Jubayed-Sahel/Neural-Rover-RC-Car/Project Files/Diagrams.docx

Main Diagram

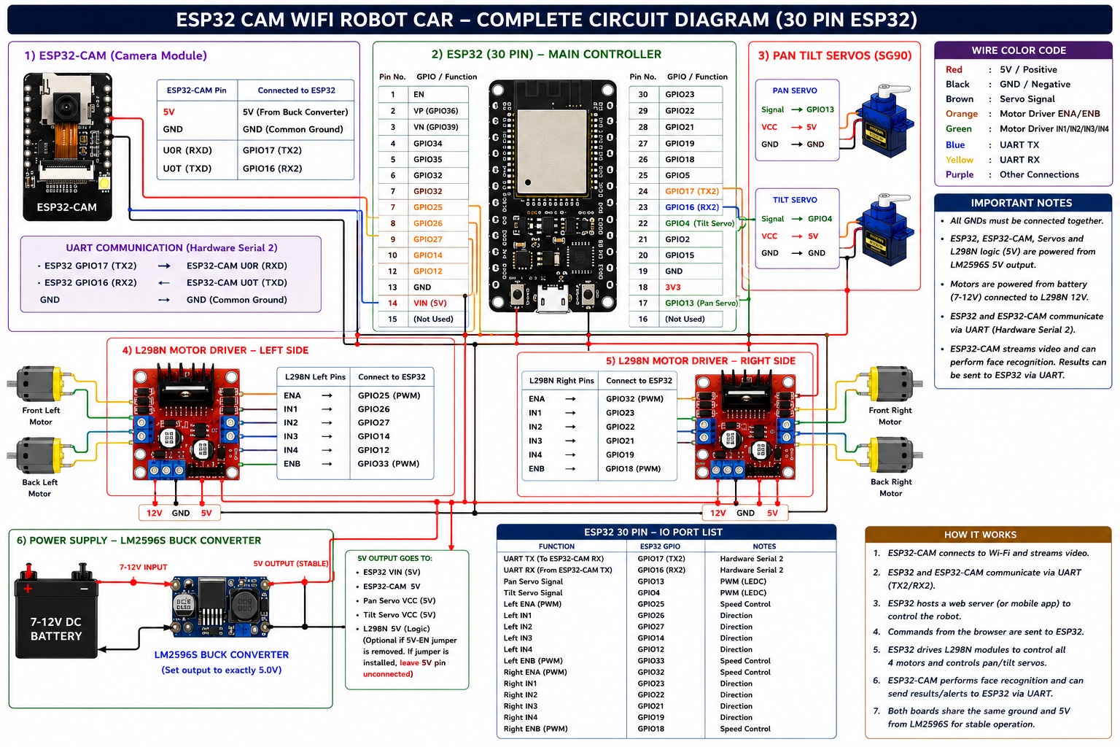
[picture p5: figure]

ESP32-CAM-Connection with hardware


ESP32-CAM Code Upload Diagram

- Must connect arduino reset pin with arduino gnd

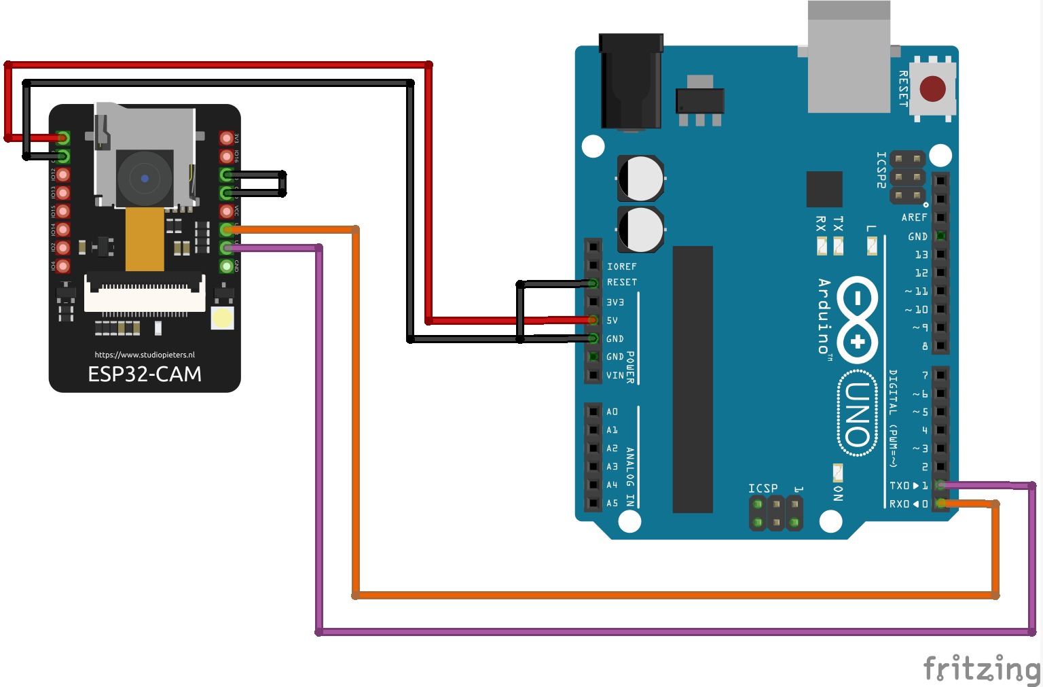
[picture p6: figure]
