Jubayed-Sahel/Neural-Rover-RC-Car/Project Files/Arduino IDE Settings_.docx

1. ESP 32 CAM Settings:

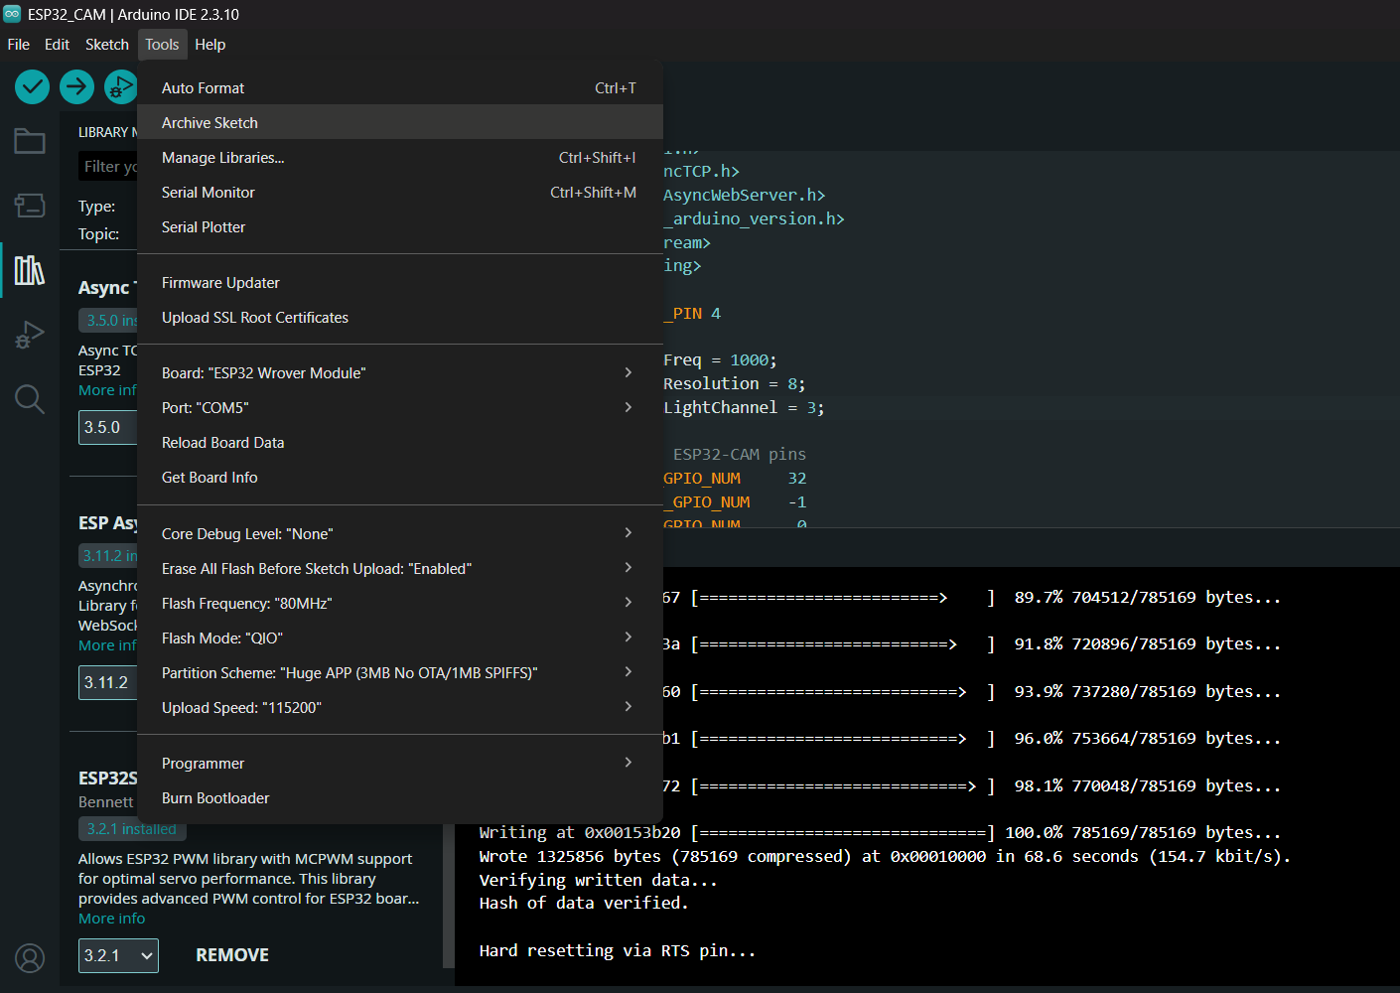
[picture p7: figure]

2. ESP 32 Contoller:
3. LIbraries :

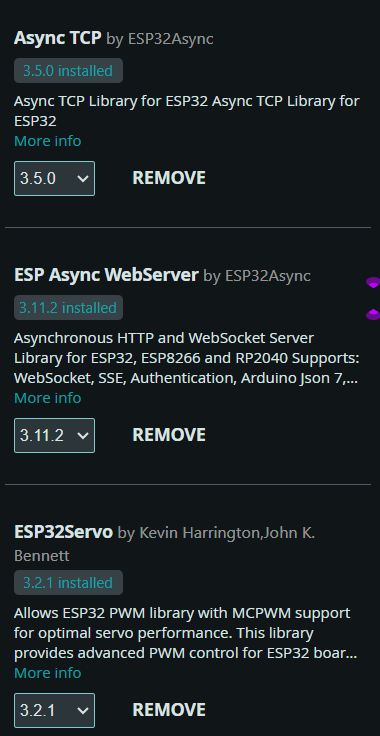
[picture p8: figure]
