Jubayed-Sahel/Neural-Rover-RC-Car/Project Files/CSE499B_Fall_Detection_Architecture.png

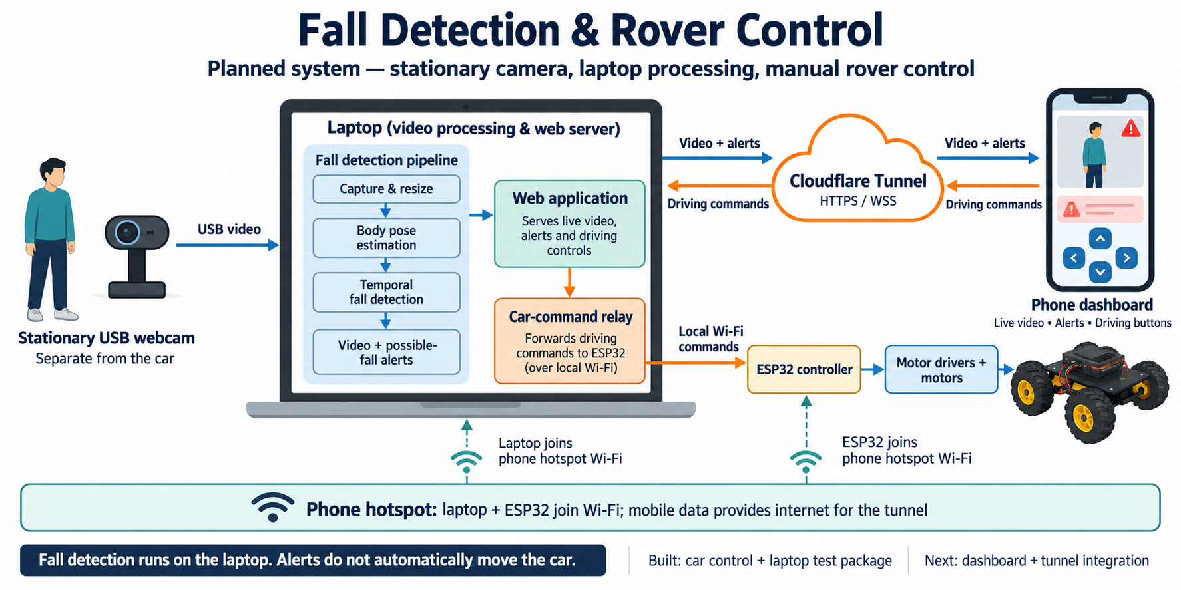
Project Files/CSE499B_Fall_Detection_Architecture.png
