Jubayed-Sahel/Neural-Rover-RC-Car/Project Files/Neural Rover Architecture Detailed.png

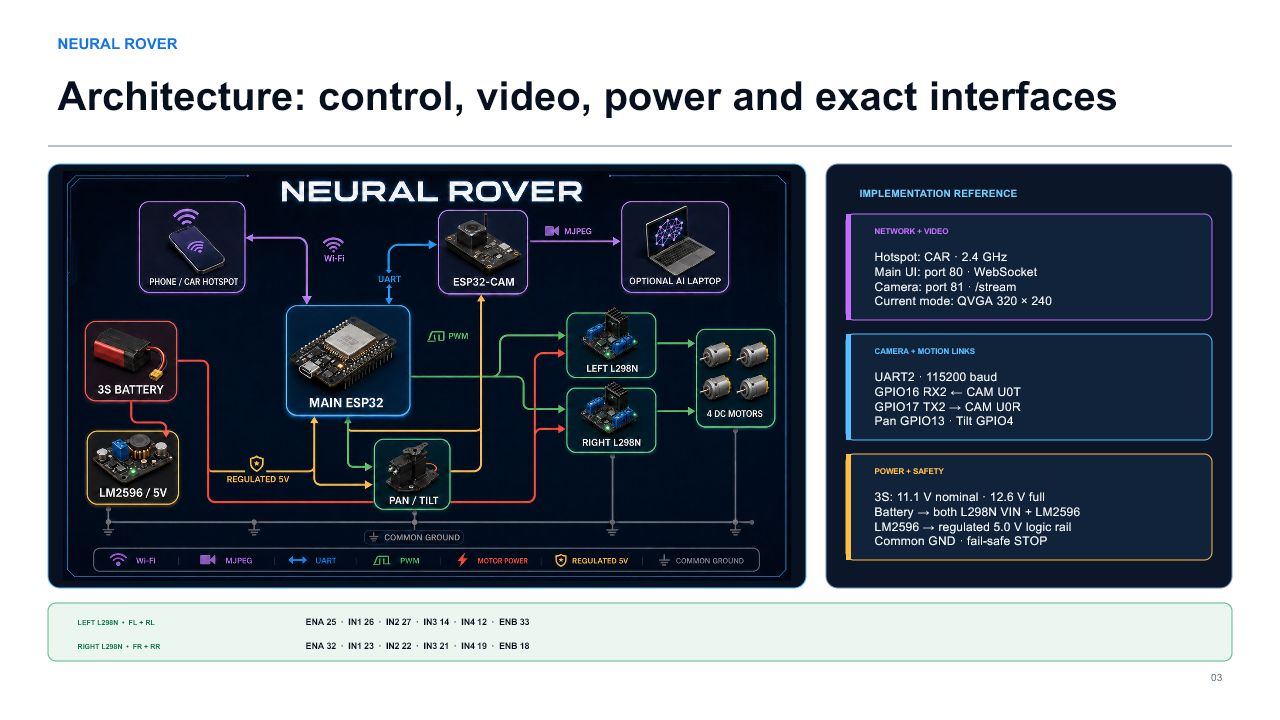
Project Files/Neural Rover Architecture Detailed.png
