Jubayed-Sahel/Neural-Rover-RC-Car/Project Files/Neural Rover Full Project Diagram.png

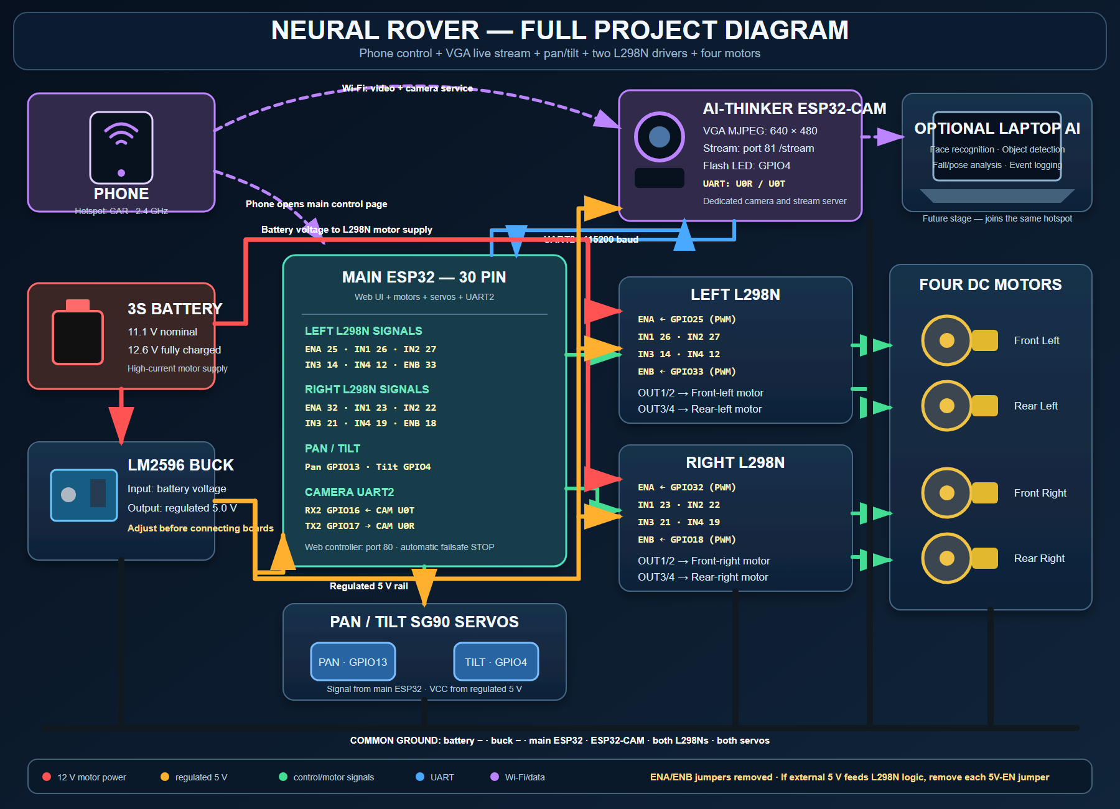
Project Files/Neural Rover Full Project Diagram.png
