Jubayed-Sahel/Neural-Rover-RC-Car/Project Files/Neural Rover Mobile Control Page.png

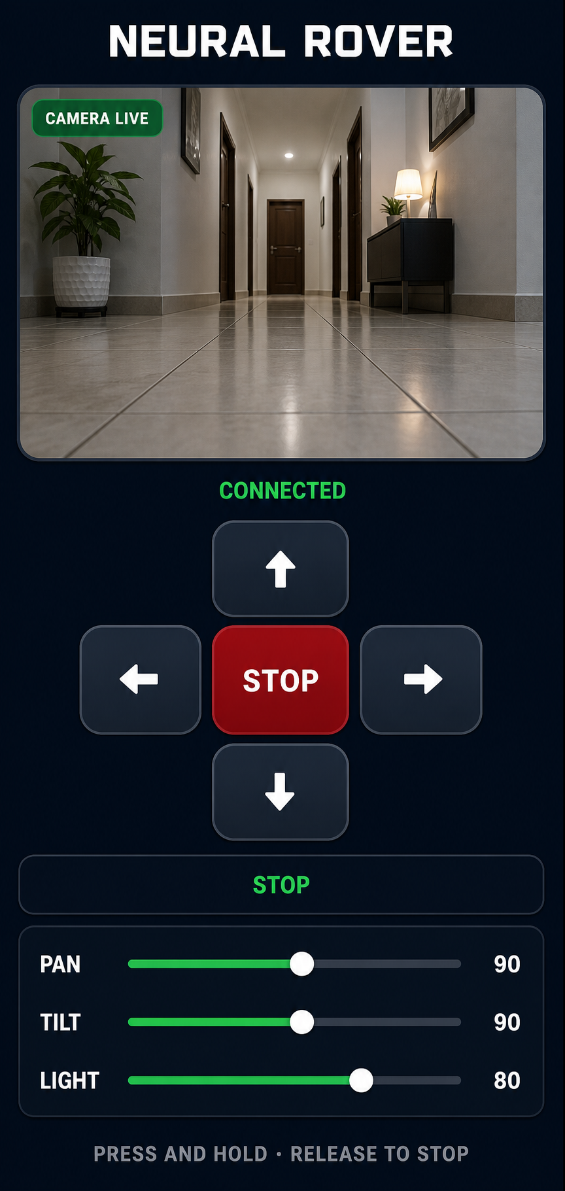
Project Files/Neural Rover Mobile Control Page.png
