Jubayed-Sahel/Neural-Rover-RC-Car/install in laptop/known_faces/README.txt

Reference photographs are stored here.

The capture program automatically creates one subfolder per person:

known_faces/
  Person_Name/
    image_01.jpg
    image_02.jpg

Use 5-10 clear images per person with slightly different face angles.
