Jubayed-Sahel/Neural-Rover-RC-Car/CSE499B_Smart_Hazard_Inspection_Rover_Proposal.docx

CSE499B PROJECT PROPOSAL

# ThermoGuard Rover

A Low-Cost Smart Hazard Inspection Rover

Remote inspection, thermal and environmental sensing, assisted driving, and fail-safe operation

Course | CSE499B - Senior Design Project
Project | Neural Rover / ThermoGuard Rover
Team | Four-member project group
Prepared for | Project supervisor and evaluation committee

Project direction: The ESP32-CAM remains a live situational-awareness camera. The main CSE499B contribution is reliable sensor-based hazard detection and safer remote operation, not face recognition or QR-code navigation.

Status entering CSE499B

The core 499A rover platform is operational; face recognition is intentionally removed from the next-phase scope.

# 1. Executive Summary

ThermoGuard Rover is a low-cost mobile platform for remotely inspecting rooms and equipment when immediate human entry may be inconvenient or unsafe. The operator drives the rover through a mobile-friendly dashboard while the ESP32-CAM provides live visual feedback. Contactless temperature sensing, ambient environmental sensing, obstacle ranging, battery monitoring, and communication supervision operate continuously. When the system detects an abnormal condition, it warns the operator, records the event, captures visual evidence, and can place the rover in a safe-stop state.

The proposal deliberately avoids face recognition and QR-code navigation. The existing camera is retained for live observation and event snapshots, where its image quality is adequate. Safety-critical decisions rely primarily on dedicated sensors, which creates a more dependable and testable CSE499B contribution.

Core research question: Can an affordable sensor-assisted rover identify thermal and environmental warning conditions while improving the safety and reliability of remote inspection compared with video-only manual control?

# 2. Background and 499A Baseline

The CSE499A phase established the physical rover and remote-control foundation. The platform already combines a four-wheel chassis, motor drivers, an ESP32-based control unit, an ESP32-CAM, pan-and-tilt camera movement, Wi-Fi communication through a mobile hotspot, and a browser-based control interface. Motor-control safeguards such as command timeout and direction-reversal dead time are also part of the baseline.

Existing capability | Status entering CSE499B
Four-wheel movement and motor control | Operational
Mobile hotspot connectivity | Operational
Browser/mobile driving interface | Operational
ESP32-CAM live stream | Operational for situational awareness
Pan-and-tilt camera control | Operational
Communication-loss motor timeout | Implemented baseline safeguard
Face recognition | Not continued because camera quality and operating conditions make it unreliable

# 3. Problem Statement and Real-Life Relevance

Electrical rooms, server rooms, laboratories, storage areas, kitchens, and recently affected spaces may contain overheating equipment, poor air conditions, obstacles, smoke, or uncertain visibility. A person often has to approach the area merely to understand the situation. A small remotely operated rover can provide an initial view and collect measurements while allowing the operator to remain at a safer distance.

The system is not intended to replace certified fire, gas, or industrial safety equipment. Its role is early warning and remote situational awareness: helping the operator decide whether closer human inspection is appropriate and preserving a record of what the rover observed.

# 4. Proposed CSE499B Objectives

- Integrate contactless thermal sensing to identify unusual heat sources or equipment hotspots.
- Measure ambient temperature, humidity, and air-quality trends using an environmental sensor.
- Add obstacle-distance sensing and prevent unsafe forward movement near an obstruction.
- Monitor battery voltage/current and warn the operator before unsafe shutdown.
- Extend the phone dashboard with live sensor values, clear warnings, rover state, and event history.
- Implement a state-based safety controller for manual driving, warning, and automatic safe stop.
- Evaluate the rover quantitatively using repeatable inspection and communication tests.

# 5. Intended Use Cases

Use case | Rover contribution | Operator benefit
Electrical equipment inspection | Measures surface temperature and shows the equipment through live video | Reduces unnecessary close approach to a suspected hotspot
Room reconnaissance | Streams video and reports environment and obstacles | Provides initial awareness before entering
Laboratory or storage check | Detects unusual heat and air-quality change and records an alert | Supports faster, evidence-based decisions
Dark or narrow-space inspection | Uses camera lighting, pan/tilt, and proximity sensing | Reaches viewpoints that are difficult to inspect directly

# 6. System Architecture

The system is divided into rover-side sensing and control, Wi-Fi communication, and an operator dashboard. The mobile hotspot remains the network access point. Heavy image analysis is not required for the minimum system, so the ESP32-CAM can focus on streaming while the main ESP32 handles motion and sensor messages.

Data flow: Sensors and ESP32-CAM -> ESP32/Wi-Fi network -> mobile-friendly dashboard -> operator commands -> safety validation -> motor and pan/tilt actuation.

## 6.1 Rover-side modules

Module | Purpose | Recommended choice
Visible camera | Live view, pan/tilt observation, and alert snapshots | Existing ESP32-CAM
Thermal sensing | Contactless hotspot measurement | MLX90614 for a simple point reading; MLX90640 for an optional 32 x 24 heat map
Environmental sensing | Temperature, humidity, and air-quality trend | BME680 or BME688
Obstacle sensing | Front clearance and collision prevention | VL53L0X/VL53L1X ToF sensor; optional left/right sensors
Power sensing | Battery voltage and current | INA219 or INA226
Rover orientation | Tip-over warning | Optional MPU6050 IMU
Local warning | Immediate visible/audible alert | Buzzer and status LED

## 6.2 Camera role

The ESP32-CAM is not used for face recognition. It provides a low-bandwidth first-person view, allows the operator to aim the camera using pan/tilt, captures an image when a sensor alarm occurs, and visually confirms whether a detected hotspot or obstacle corresponds to a real object. This role remains valuable even at moderate resolution.

## 6.3 Safety-state logic

State | Meaning | Typical transition
MANUAL | Normal remote driving | Operator enables assisted mode
ASSISTED | Manual driving with obstacle and safety checks | Obstacle, low battery, weak connection, or hazard warning
WARNING | A condition needs operator attention | Condition clears or becomes critical
SAFE STOP | Motors are disabled and movement commands are rejected | Operator acknowledges and conditions become safe

# 7. Functional Requirements

- The dashboard shall display live video, drive controls, camera controls, sensor readings, battery status, connection status, and the current safety state.
- The rover shall stop or reject forward movement when the front distance is below a configurable limit.
- The rover shall generate a thermal warning when a measured value exceeds a configurable threshold or differs significantly from the local baseline.
- The rover shall issue an air-quality trend warning without claiming certified gas identification.
- The rover shall stop its motors when valid control commands are not received within the configured timeout.
- The system shall record timestamped movement, warning, connection, and battery events.
- The operator shall be able to capture and save a camera snapshot during an inspection.

# 8. Software Design

## 8.1 Embedded firmware

The main ESP32 firmware will read I2C sensors, validate motion commands, maintain the safety state, control motor outputs, and transmit structured telemetry. Sensor acquisition and motor control should use separate timed tasks so a slow dashboard or camera stream cannot disable the local safety logic.

## 8.2 Dashboard

The existing browser interface will be expanded into an operator console. Large touch controls remain available for driving, while compact cards display obstacle distance, temperature, air-quality trend, battery, hotspot status, connection quality, and warnings. A clear STOP control must remain visible at all times.

## 8.3 Event logging

Each significant event should contain a timestamp, event type, measured value, rover state, and optional snapshot filename. Data may initially be stored on the controlling laptop as CSV or JSON. This keeps the embedded system simple and makes later analysis and report generation straightforward.

# 9. Operating Sequence

1. The operator powers the rover and connects the rover and controller to the mobile hotspot.
2. The dashboard confirms motor controller, camera, sensor, and battery status.
3. The operator selects Assisted mode and drives toward the inspection area.
4. The rover continuously reports video, obstacle distance, environmental readings, and temperature measurements.
5. If an abnormal condition occurs, the rover warns the operator, records the reading, and captures visual evidence.
6. If communication is lost, battery becomes critical, or an obstacle is dangerously close, the rover enters Safe Stop.
7. The operator reviews the event log and exports the inspection results after the mission.

# 10. Implementation Plan

Phase | Weeks | Main activities | Output
1. Design | 1-2 | Finalize thresholds, component interfaces, dashboard layout, and test scenarios | Approved specification and wiring plan
2. Sensor integration | 3-4 | Integrate thermal, environmental, obstacle, and power sensors | Stable telemetry from all sensors
3. Dashboard upgrade | 5-6 | Add gauges, warnings, states, connection status, and event display | Mobile-friendly operator console
4. Safety controller | 7-8 | Implement assisted stopping, hazard states, battery response, and fail-safe behaviour | Integrated safe-control prototype
5. Logging and evidence | 9-10 | Record events and snapshots; add export support | Inspection dataset and report-ready output
6. Testing | 11-12 | Run controlled thermal, obstacle, network, and endurance experiments | Evaluation results
7. Finalization | 13-14 | Tune thresholds, fix defects, write report, and rehearse demonstration | Final rover, report, and presentation

# 11. Four-Member Team Allocation

Member | Primary responsibility | Supporting responsibility
Member 1 | Sensor integration and calibration | Hardware documentation and test setup
Member 2 | ESP32 motor-control and safety-state firmware | Power monitoring and fail-safe tests
Member 3 | Dashboard, communication, and event logging | Data visualization and result export
Member 4 | System integration, experiments, and analysis | Report, presentation, and demonstration coordination

All four members should participate in integration testing and understand the complete signal flow so that each person can explain the system during the final presentation.

# 12. Minimum Viable Product and Stretch Goals

Minimum viable product | Stretch goals if time and budget permit
Manual phone control with live camera | 32 x 24 thermal heat-map visualization
Single front obstacle sensor and assisted stop | Left/right obstacle sensing and speed reduction
Contactless temperature and environmental readings | Tip-over detection using an IMU
Battery and connection warnings | Trend comparison across repeated inspections
Safe stop and event log | Automatic PDF inspection summary or remote notification

# 13. Evaluation Methodology

Testing should use safe, repeatable scenarios. A warm lamp, power adapter, resistor under controlled power, or laboratory heating element may simulate an abnormal hotspot. Dangerous mains faults, open flames, and harmful gas releases must not be created for demonstration purposes.

Metric | Method | Example success target
Hotspot detection rate | Repeat normal and heated-target trials at fixed distances | At least 90% detection in the defined operating range
Temperature error | Compare rover reading with a reference thermometer | Document mean absolute error and variation
Obstacle-stop success | Approach a fixed obstacle from repeated starting points | No collision in at least 19 of 20 assisted trials
Safe-stop response | Interrupt command transmission while the rover moves | Motors stop within the configured timeout
Control latency | Timestamp command transmission and response | Report median and worst-case delay
Video continuity | Run indoor inspections at different distances from the hotspot phone | Report freezes, disconnections, and recovery time
Battery endurance | Operate the full system using a repeatable drive cycle | Report usable runtime and low-battery behaviour
Operator performance | Compare video-only and sensor-assisted obstacle courses | Fewer collisions or faster safe completion in assisted mode

# 14. Demonstration Scenario

1. Create a small indoor route with a dark section, an obstacle, and a safely heated target.
2. Drive the rover from the phone while presenting the live camera and sensor dashboard.
3. Demonstrate automatic stopping before the obstacle.
4. Aim the thermal sensor at the heated target and trigger a warning and snapshot.
5. Show the event entry containing time, temperature, rover state, and battery condition.
6. Disable the controller connection and demonstrate the communication-loss safe stop.

# 15. Expected Outcomes

- A complete low-cost prototype for remote hazard reconnaissance and equipment inspection.
- A mobile interface that combines live observation, sensing, warnings, and control.
- Quantitative evidence showing the benefit and limitations of sensor-assisted operation.
- A reusable architecture that can later accept improved cameras, thermal arrays, more distance sensors, or autonomous navigation.

# 16. Limitations and Responsible Claims

Limitation | Responsible treatment
ESP32-CAM resolution and motion blur | Use it for situational awareness and snapshots, not identity recognition
Low-cost air-quality sensors are not certified gas detectors | Report trends and warnings only; do not identify a specific gas without suitable instrumentation
Thermal sensors depend on distance, field of view, surface properties, and calibration | Define and test a limited operating range; report uncertainty
Wi-Fi depends on the hotspot and building environment | Display connection status and maintain a local command-timeout safe stop
Four-wheel hobby chassis cannot handle stairs, water, or heavy debris | Limit the stated use case to level indoor floors and controlled environments

Project claim: ThermoGuard Rover is an academic early-warning and remote-inspection prototype. It is not a certified fire detector, gas detector, medical device, or autonomous emergency-response system.

# 17. Final Deliverables

- Integrated rover with documented hardware and wiring.
- ESP32 control and sensor firmware.
- Mobile-friendly operator dashboard with live video and telemetry.
- Event log and captured inspection evidence.
- Experimental dataset, analysis, and evaluation chapter.
- Final CSE499B report, presentation, and live demonstration.

# 18. Reference Basis

NIST describes response robots as remotely deployed systems that improve situational awareness, perform operational tasks, and reduce risk to the operator. Its test framework emphasizes sensing, mobility, energy, radio communication, human-robot interaction, and safety. This proposal follows the same capability-oriented approach at undergraduate prototype scale.

National Institute of Standards and Technology. Department of Homeland Security Response Robot Performance Standards. https://www.nist.gov/programs-projects/department-homeland-security-response-robot-performance-standards

National Institute of Standards and Technology. Ground Robot Tests. https://www.nist.gov/el/intelligent-systems-division-73500/standard-test-methods-response-robots/ground-robot-tests

Melexis. MLX90640 Far Infrared Thermal Sensor Array. https://www.melexis.com/en/product/mlx90640/far-infrared-thermal-sensor-array

Neural Rover - CSE499B |

CSE499B PROJECT PROPOSAL | SMART HAZARD INSPECTION ROVER
