Jubayed-Sahel/Neural-Rover-RC-Car/(commit log)

2026-07-29 Working Cam and ESP32 both but pan tilt setup remaining
2026-08-18 docs: feature final rover prototype
2026-10-13 Document ground-level detection requirements and camera comparison
2026-10-14 Update project plan for Wi-Fi camera and RTSP testing
